Student-Satellite-IITB/Communication-Subsystem/README.md

# Communication-Subsystem
This repository contains all codes related to the Communication Subsystem for IITBSSP CubeSat Mission

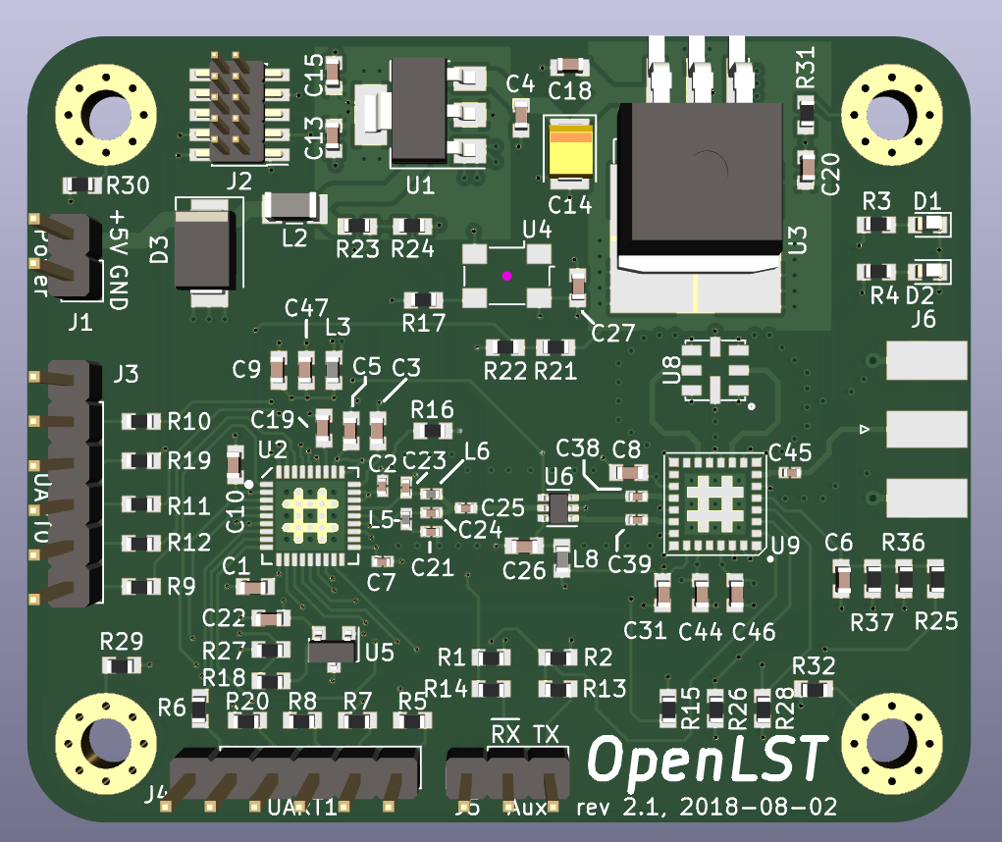
[picture p1: Images/openlst-board.png]
OpenLST Transceiver Board


Current status: 
- Literature Review
- Link Budget Analysis
