Student-Satellite-IITB/Communication-Subsystem/DevelopmentBoards/ADS_v6/Resistor Board/Resistor board.DXF

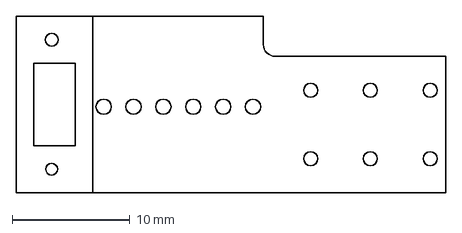
[picture p2: CAD file, 2025-07-12]
DevelopmentBoards/ADS_v6/Resistor Board/Resistor board.DXF
36.5 x 15.0 mm
