Student-Satellite-IITB/Communication-Subsystem/DevelopmentBoards/ADS_v6/Sanket Deployment board/Sanket.step

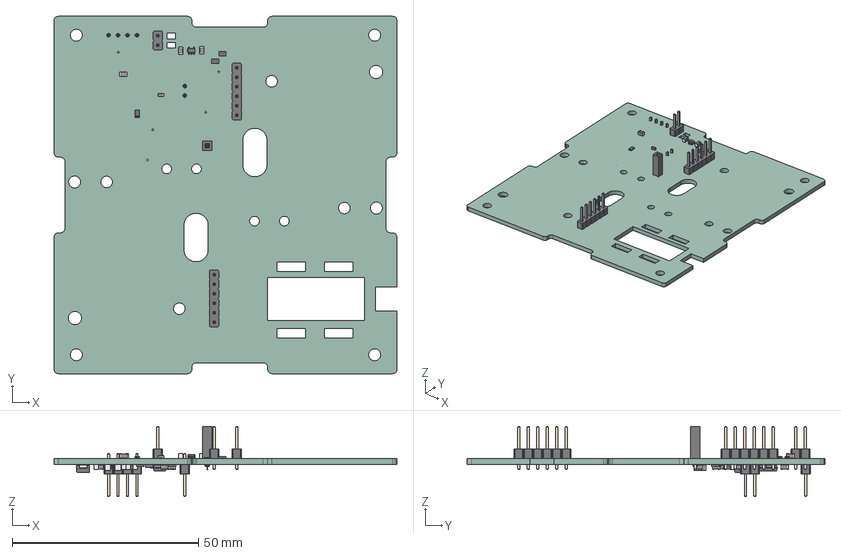
[picture p3: CAD file, 2025-08-22]
DevelopmentBoards/ADS_v6/Sanket Deployment board/Sanket.step
92.0 x 95.9 x 18.8 mm
PinSocket_1x01_P2.54mm_Vertical
PinHeader_1x06_P254mm_Vertical x 2
R_0805_2012Metric x 8
C_0603_1608Metric
C_0805_2012Metric x 17
PinHeader_1x02_P254mm_Vertical x 2
SOT_353_SC_70_5
WSON_6_1EP_2x2mm_P065mm_EP1x16mm
C_1206_3216Metric x 2
D_SMB
PinHeader_1x04_P254mm_Vertical
DGQ0010D_ASM
sanket_PCB
