Student-Satellite-IITB/Communication-Subsystem/DevelopmentBoards/ADS_v6/Sanket Deployment board/Ref_PCB.dxf

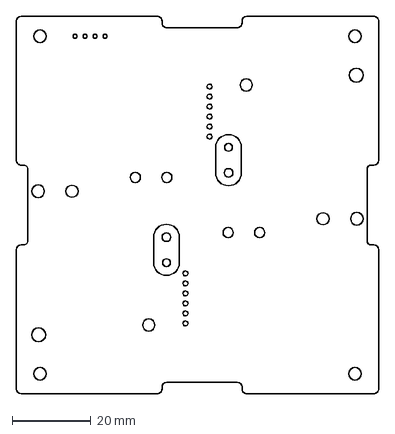
[picture p4: CAD file, 2025-07-12]
DevelopmentBoards/ADS_v6/Sanket Deployment board/Ref_PCB.dxf
92.0 x 95.9 mm
