Student-Satellite-IITB/Communication-Subsystem/DevelopmentBoards/ADS_v4/Sanket Deployment board/Sanket.step

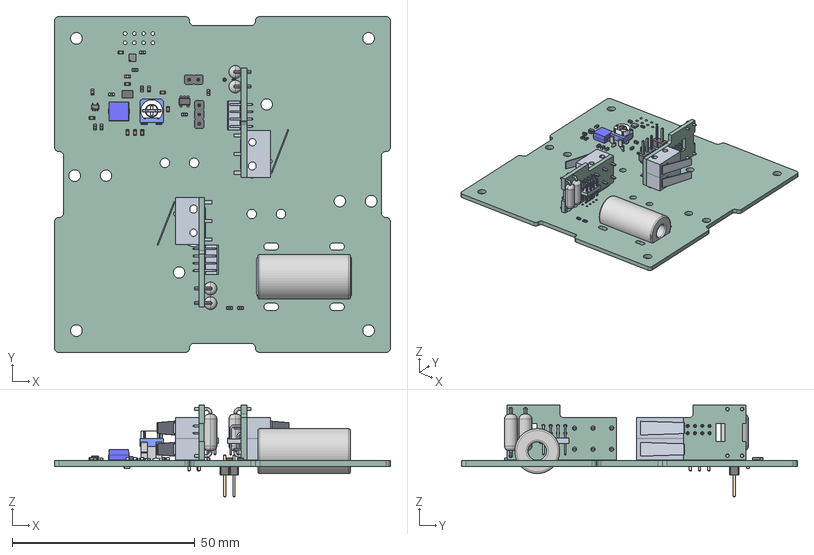
[picture p5: CAD file, 2025-03-31, an earlier design]
DevelopmentBoards/ADS_v4/Sanket Deployment board/Sanket.step
92.0 x 92.0 x 25.1 mm
ASSEMBLY x 12
C0603C823K4RACTU x 11
MAX825TEUK+T
PinHeader_1x02_P254mm_Vertical x 2
DCK5
ferrite v1
PinHeader_1x03_P254mm_Vertical
Trimpot Horiz 5mm v4
resistor_board 1 x 2
RWY0009C_ASM
DRV6
sanket 4.0_PCB
