Student-Satellite-IITB/Communication-Subsystem/Testing/README.md

# Communication-Subsystem Design and Analysis

This document is a work in progress
