Student-Satellite-IITB/Communication-Subsystem/(threads)

Thread 2 (2025-03-31):

ADS board

paritkary25, 2025-03-31:
The ADS project is blank. Upload correct ADS mainboard and detector board files.
