Student-Satellite-IITB/Communication-Subsystem/DevelopmentBoards/ADS_v6/Sanket Deployment board/sch.pdf

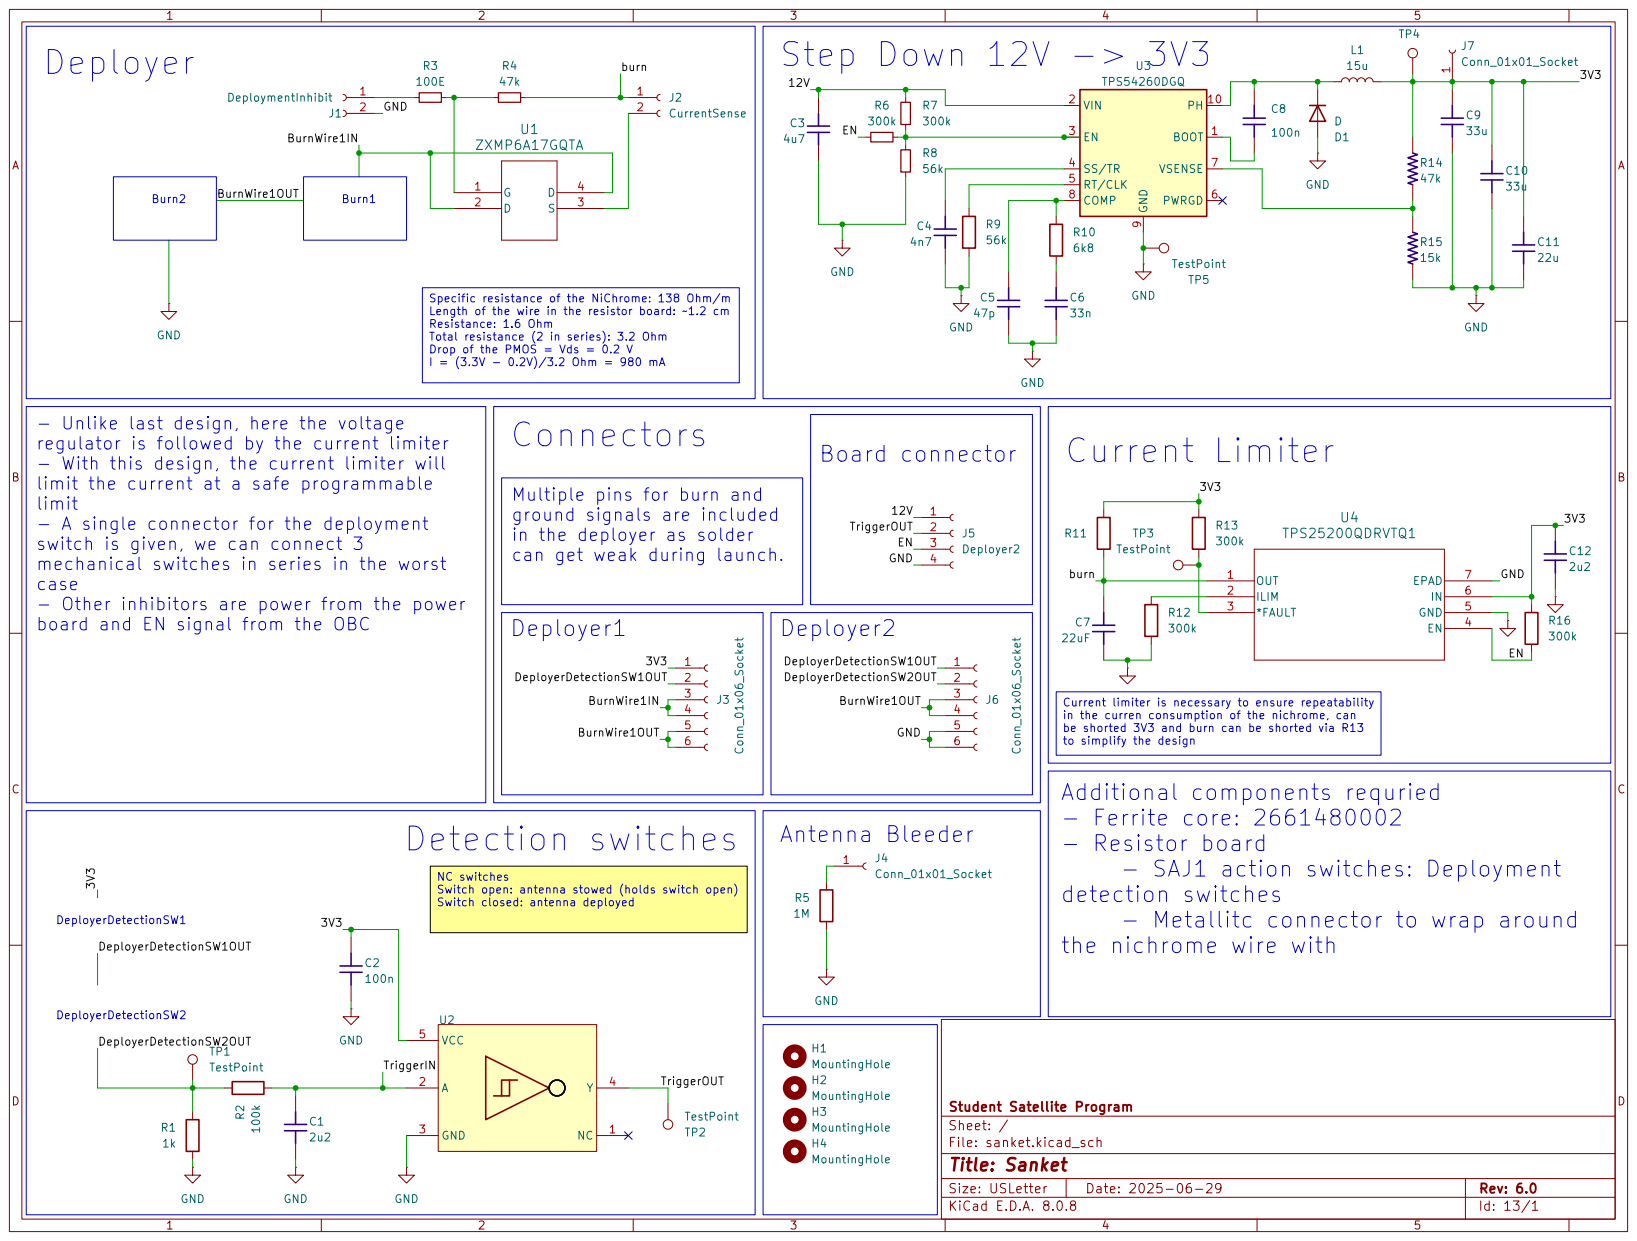
[picture p6: page 1]
