Student-Satellite-IITB/Communication-Subsystem/(list of files, drawings)

Other design files:
DevelopmentBoards/ADS_v6/Resistor Board/electromechanical.PcbLib
DevelopmentBoards/ADS_v6/Resistor Board/electromechanical.SchLib
