Student-Satellite-IITB/Communication-Subsystem/DevelopmentBoards/ADS_v6/Resistor Board/resistor_board.kicad_pcb

## KiCad design DevelopmentBoards/ADS_v6/Resistor Board/resistor_board.kicad_pcb (2025-07-12)

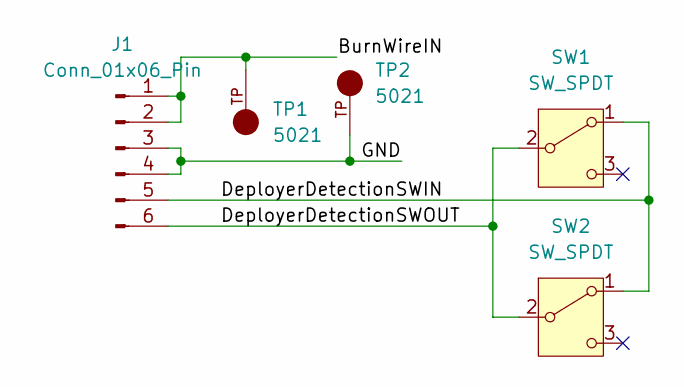
[picture p7: schematic resistor_board.kicad_sch, Antenna Burn Wire PCB]

Parts:
J1: Conn_01x06_Pin; PinHeader_1x06_P2.54mm_Vertical
SW1, SW2: SW_SPDT; D2F-L_OMR
TP1, TP2: 5021; TP_5021; PARTREV B

Connections:
/BurnWireIN: J1.1, J1.2, TP1.TP
/DeployerDetectionSWIN: J1.5, SW1.1 (A), SW2.1 (A)
/DeployerDetectionSWOUT: J1.6, SW1.2 (B), SW2.2 (B)
/GND: J1.3, J1.4, TP2.TP

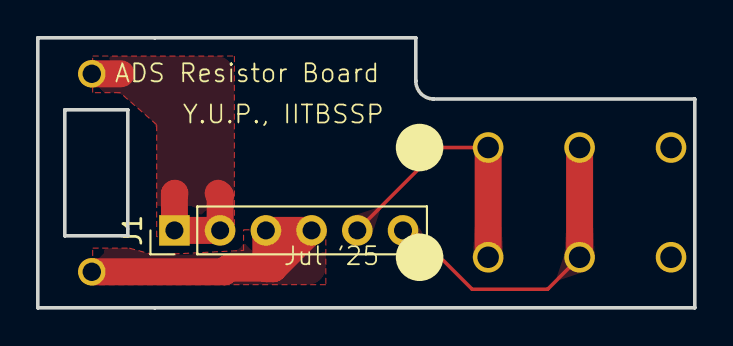
[picture p8: board DevelopmentBoards/ADS_v6/Resistor Board/resistor_board.kicad_pcb from above]

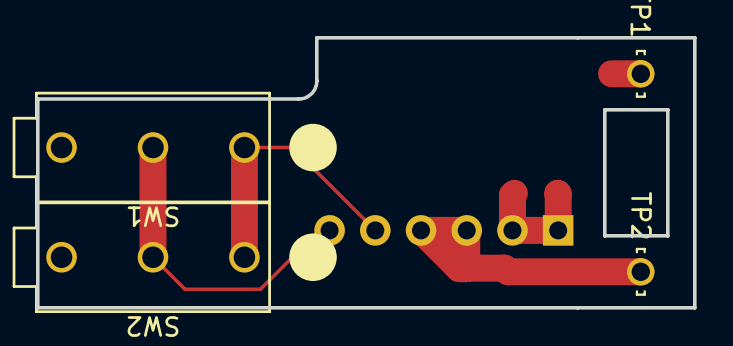
[picture p9: board DevelopmentBoards/ADS_v6/Resistor Board/resistor_board.kicad_pcb from below]

Board: 2 copper layers, 36.5 x 15.0 mm, 5 parts (4 on the bottom side), 4 nets.
