Student-Satellite-IITB/Communication-Subsystem/DevelopmentBoards/ADS_v6/Sanket Deployment board/sanket.kicad_pcb

## KiCad design DevelopmentBoards/ADS_v6/Sanket Deployment board/sanket.kicad_pcb (2025-08-22)

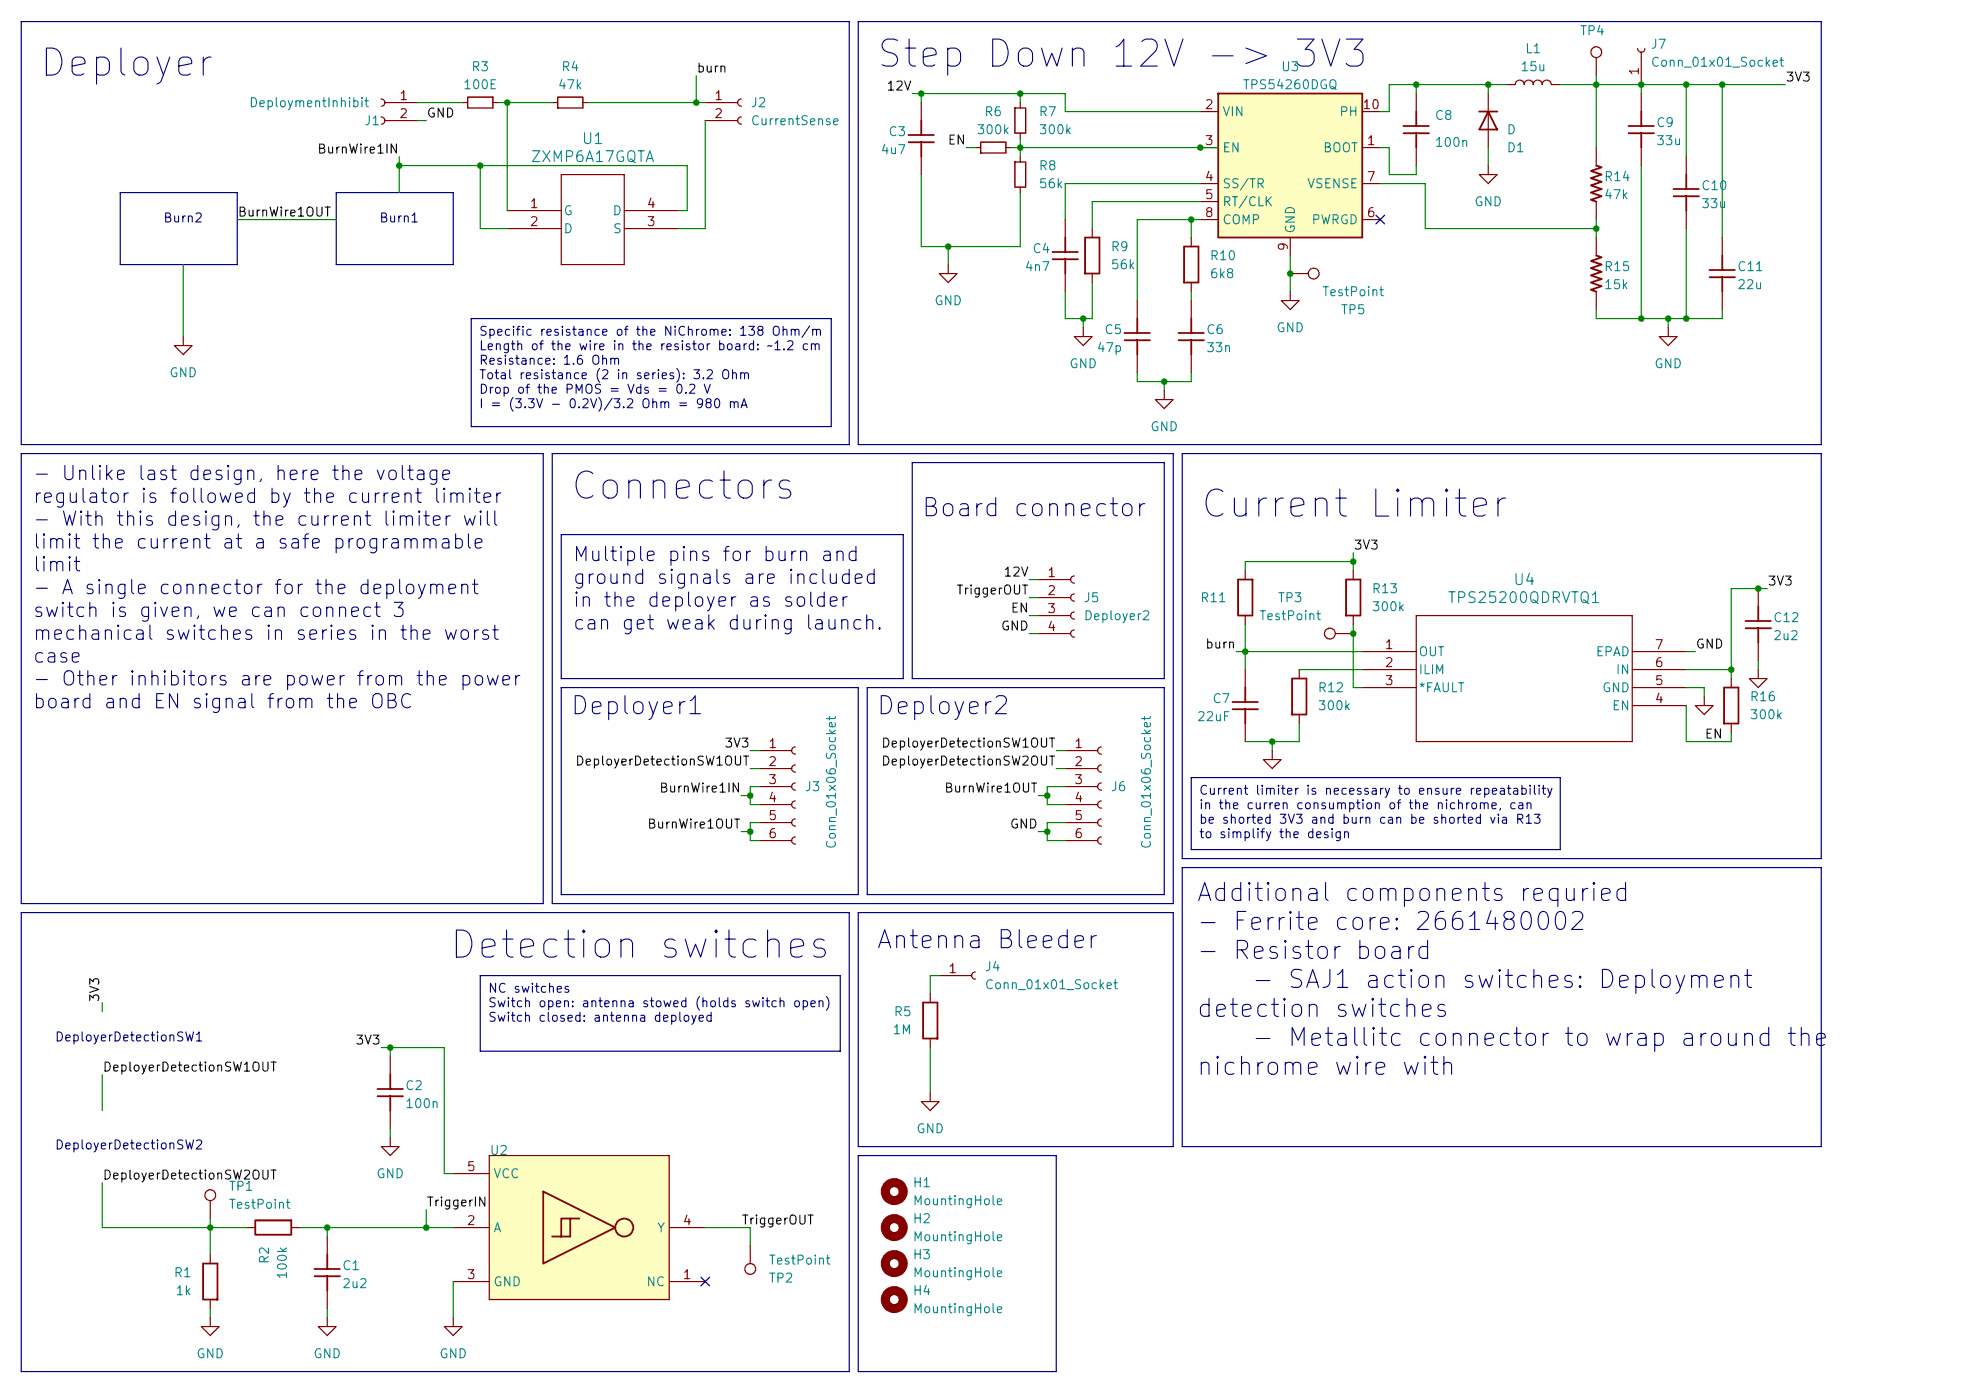
[picture p10: schematic sanket.kicad_sch]

Parts:
C1, C12: 2u2; C_0805_2012Metric
C2: 100n; C_0805_2012Metric
C3: 4u7; C_0805_2012Metric; MANUFACTURER PART NUMBER C0603C475K8PACTU
C4: 4n7; C_0805_2012Metric; MANUFACTURER PART NUMBER C0603C475K8PACTU
C5: 47p; C_0805_2012Metric; MANUFACTURER PART NUMBER C0603C475K8PACTU
C6: 33n; C_0805_2012Metric; MANUFACTURER PART NUMBER C0603C475K8PACTU
C7: 22uF; C_0805_2012Metric
C8: 100n; C_0805_2012Metric; MANUFACTURER PART NUMBER C0603C475K8PACTU
C9, C10: 33u; C_1206_3216Metric; MANUFACTURER PART NUMBER C0603C475K8PACTU
C11: 22u; C_0805_2012Metric; MANUFACTURER PART NUMBER C0603C475K8PACTU
D1: D; D_SMA-SMB_Universal_Handsoldering
H1, H2, H3, H4: MountingHole; MountingHole_3.2mm_M3
J1: DeploymentInhibit; PinHeader_1x02_P2.54mm_Vertical
J2: CurrentSense; PinHeader_1x02_P2.54mm_Vertical
J3, J6: Conn_01x06_Socket; PinHeader_1x06_P2.54mm_Vertical
J4, J7: Conn_01x01_Socket; PinSocket_1x01_P2.54mm_Vertical
J5: Deployer2; PinHeader_1x04_P2.54mm_Vertical
L1: 15u; L_Wurth_WE-XHMI-5050
R1: 1k; R_0805_2012Metric
R2: 100k; R_0805_2012Metric
R3: 100E; C_0805_2012Metric
R4, R14: 47k; C_0805_2012Metric
R5: 1M; R_0805_2012Metric
R6, R7: 300k; C_0805_2012Metric
R8: 56k; C_0805_2012Metric
R9: 56k; R_0805_2012Metric
R10: 6k8; R_0805_2012Metric
R11: 300k; C_0603_1608Metric
R12, R13, R16: 300k; R_0805_2012Metric
R15: 15k; C_0805_2012Metric
TP1, TP2, TP3, TP4, TP5: TestPoint; TestPoint_THTPad_1.0x1.0mm_Drill0.5mm
U1: ZXMP6A17GQTA; SOT-223_DIO
U2: SN74LVC1G17QDCKRQ1; SOT-353_SC-70-5
U3: TPS54260DGQ; HVSSOP-10-1EP_3x3mm_P0.5mm_EP1.57x1.88mm
U4: TPS25200QDRVTQ1; WSON-6-1EP_2x2mm_P0.65mm_EP1x1.6mm

Connections:
/3V3: C2.2, C9.2, C10.2, C11.2, C12.2, J3.1, J7.1, L1.2, R11.2, R13.1, R14.1, R16.1, TP4.1, U2.5 (VCC), U4.6 (IN)
/12V: C3.2, J5.1, R7.1, U3.2 (VIN)
/BurnWire1IN: J3.3, J3.4, U1.2 (D), U1.4 (D)
/BurnWire1OUT: J3.5, J3.6, J6.3, J6.4
/DeployerDetectionSW1OUT: J3.2, J6.1
/DeployerDetectionSW2OUT: J6.2, R1.1, R2.1, TP1.1
/EN: J5.3, R6.1, R16.2, U4.4 (EN)
/TriggerIN: C1.2, R2.2, U2.2 (A)
/TriggerOUT: J5.2, TP2.1, U2.4 (Y)
/burn: C7.2, J2.1, R4.2, R11.1, U4.1 (OUT)
GND: C1.1, C2.1, C3.1, C4.1, C5.1, C6.1, C7.1, C9.1, C10.1, C11.1, C12.1, D1.2 (A), J1.2, J5.4, J6.5, J6.6, R1.2, R5.2, R8.2, R9.2, R12.2, R15.2, TP5.1, U2.3 (GND), U3.9 (GND), U3.11 (GND), U4.5 (GND), U4.7 (EPAD)
unnamed: C6.2, R10.2
unnamed: C8.2, D1.1 (K), L1.1, U3.10 (PH)
unnamed: J1.1, R3.2
unnamed: J2.2, U1.3 (S)
unnamed: J4.1, R5.1
unnamed: R3.1, R4.1, U1.1 (G)
unnamed: C8.1, U3.1 (BOOT)
unnamed: C5.2, R10.1, U3.8 (COMP)
unnamed: R6.2, R7.2, R8.1, U3.3 (EN)
unnamed: R9.1, U3.5 (RT/CLK)
unnamed: C4.2, U3.4 (SS/TR)
unnamed: R14.2, R15.1, U3.7 (VSENSE)
unnamed: R13.2, TP3.1, U4.3 (*FAULT)
unnamed: R12.1, U4.2 (ILIM)

Notes on the sheet:
Multiple pins for burn and ground signals are included in the deployer as solder can get weak during launch.
NC switches Switch open: antenna stowed (holds switch open) Switch closed: antenna deployed
- Unlike last design, here the voltage regulator is followed by the current limiter - With this design, the current limiter will limit the current at a safe programmable limit - A single connector for the deployment switch is given, we can connect 3 mechanical switches in series in the worst case -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
Additional components requried - Ferrite core: 2661480002 - Resistor board - SAJ1 action switches: Deployment detection switches - Metallitc connector to wrap around the nichrome wire with
Current limiter is necessary to ensure repeatability in the curren consumption of the nichrome, can be shorted 3V3 and burn can be shorted via R13 to simplify the design
Specific resistance of the NiChrome: 138 Ohm/m Length of the wire in the resistor board: ~1.2 cm Resistance: 1.6 Ohm Total resistance (2 in series): 3.2 Ohm Drop of the PMOS = Vds = 0.2 V I = (3.3V - 0.2V)/3.2 Ohm = 980 mA
Step Down 12V -> 3V3
Detection switches
Connectors
Board connector
Deployer
Burn1
DeployerDetectionSW1
Deployer2
Current Limiter
Deployer1
DeployerDetectionSW2
Burn2
Antenna Bleeder

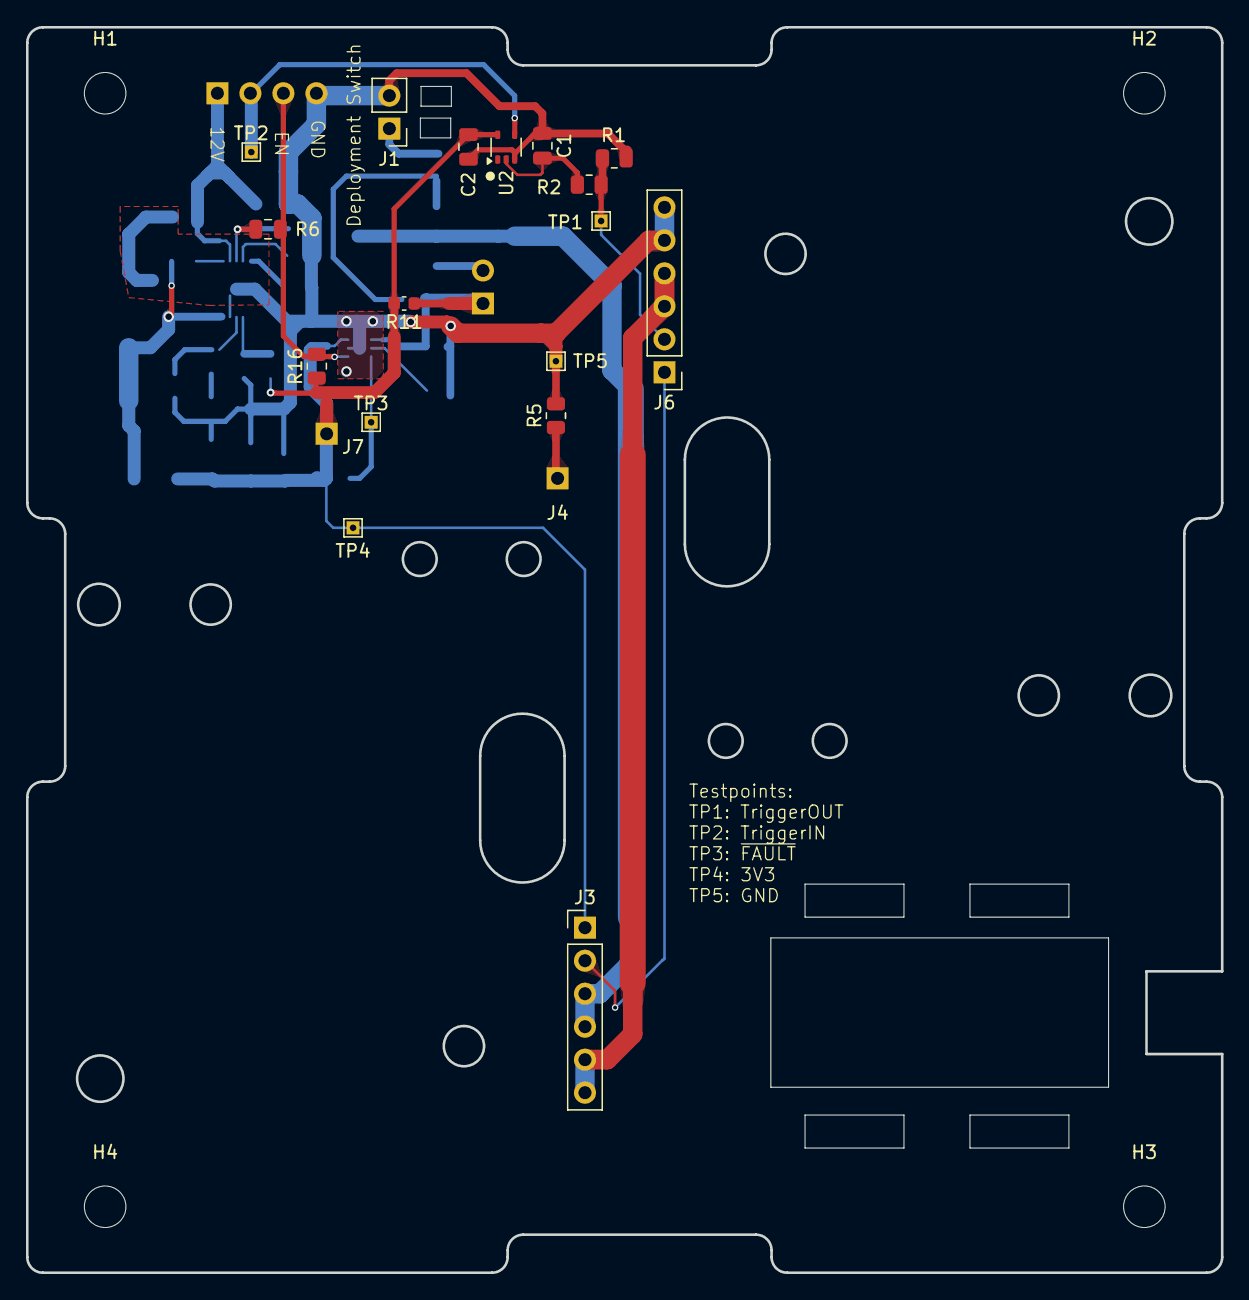
[picture p11: board sanket.kicad_pcb from above]

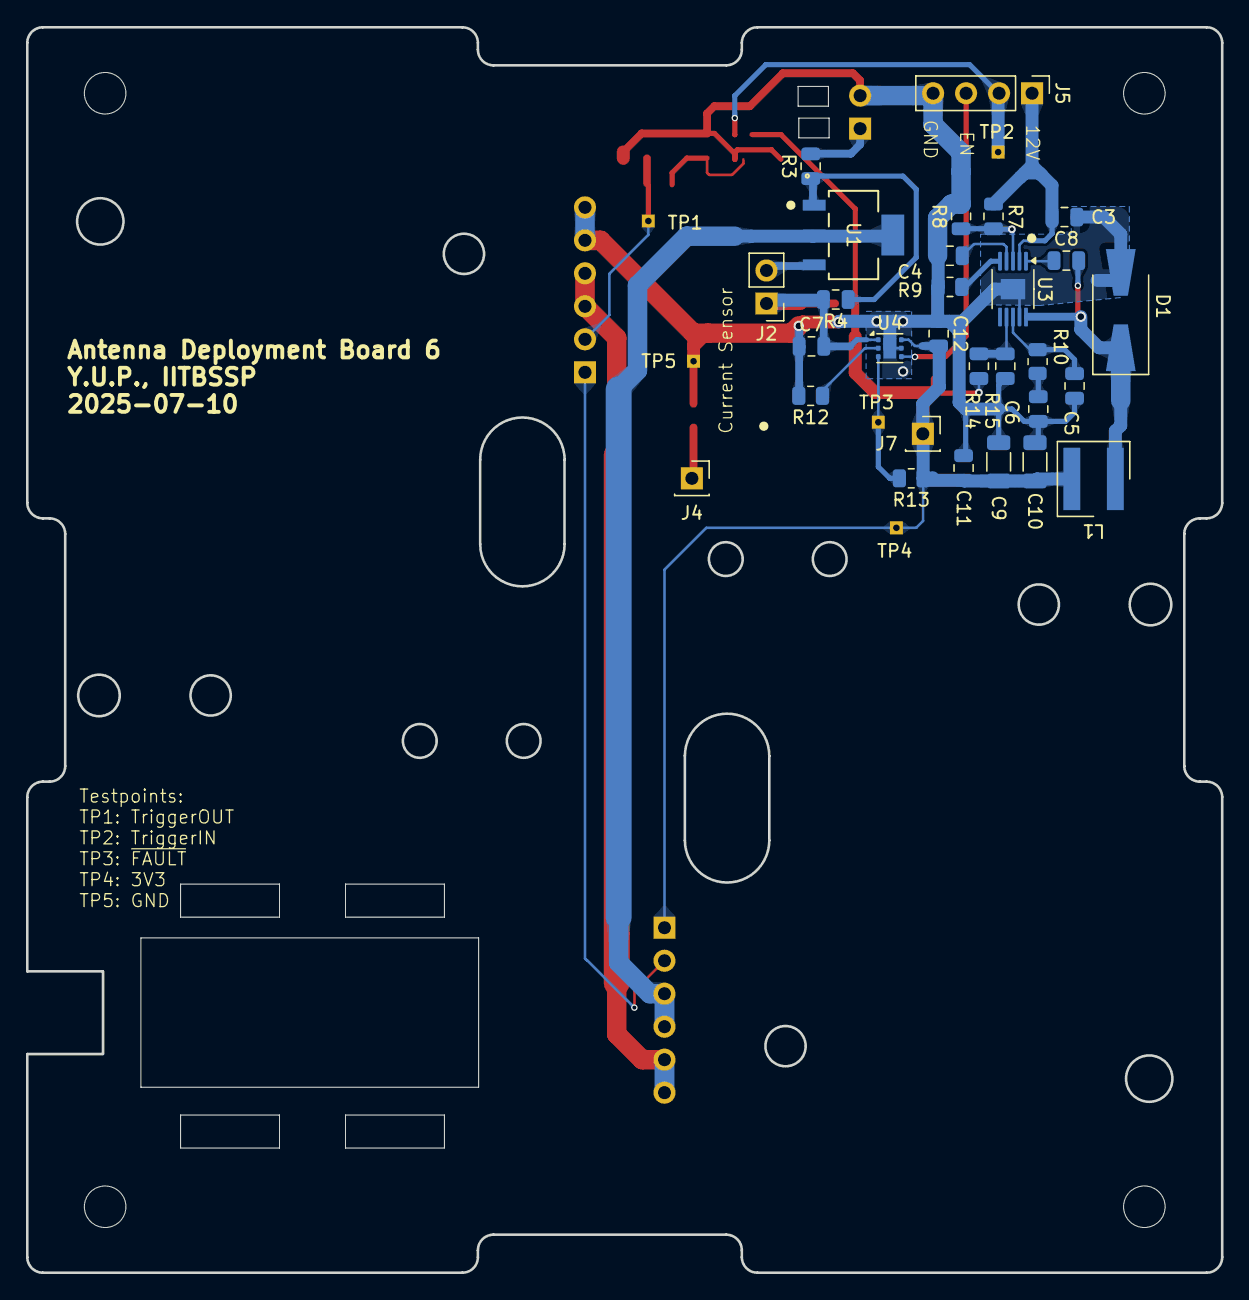
[picture p12: board sanket.kicad_pcb from below]

Board: 2 copper layers, 92.0 x 95.9 mm, 50 parts (29 on the bottom side), 25 nets.
