Student-Satellite-IITB/Communication-Subsystem/DevelopmentBoards/ADS_v4/Sanket Deployment board/sanket 4.0.kicad_pcb

## KiCad design DevelopmentBoards/ADS_v4/Sanket Deployment board/sanket 4.0.kicad_pcb (2025-03-31, an earlier design)

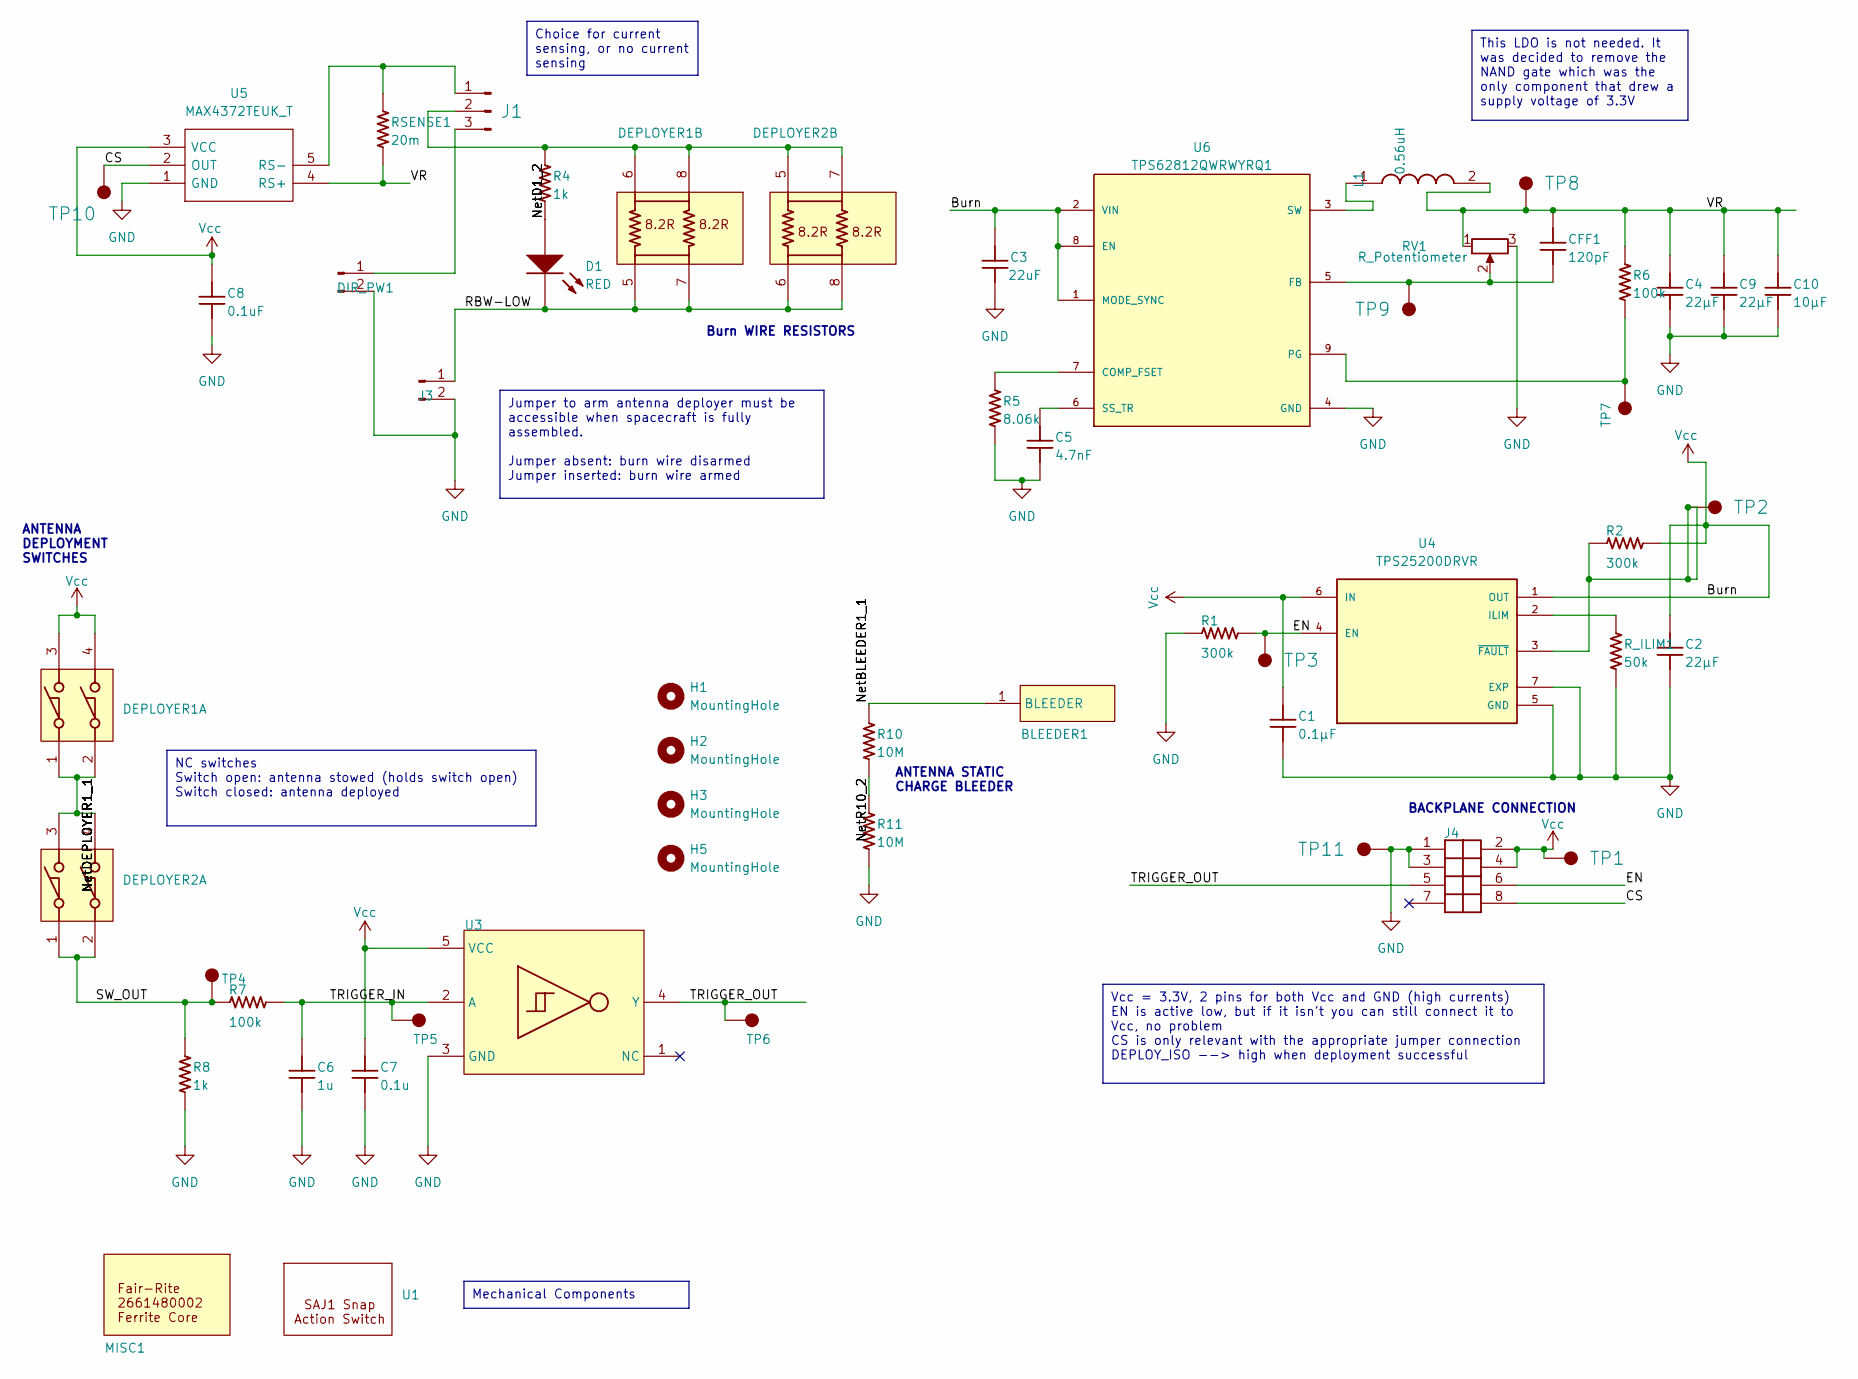
[picture p13: schematic sanket 4.0.kicad_sch, Sanket]

Parts:
BLEEDER1: Present (no need to buy); MISC-BLEEDER-PAD
C1: 0.1µF; CAP-0603-KEMET
C2: 22µF; CAP-0603-KEMET
C3: 22uF; CAP-0603-KEMET; MANUFACTURER PART NUMBER C0603C475K8PACTU
C4, C9: 22µF; CAP-0603-KEMET; MANUFACTURER PART NUMBER C0603C475K8PACTU
C5: 4.7nF; CAP-0603-KEMET; MANUFACTURER PART NUMBER C0603C475K8PACTU
C6: 1u; CAP-0603-KEMET
C7: 0.1u; CAP-0603-KEMET
C8: 0.1uF; CAP-0603-KEMET
C10: 10µF; CAP-0603-KEMET; MANUFACTURER PART NUMBER C0603C475K8PACTU
CFF1: 120pF; CAP-0603-KEMET; MANUFACTURER PART NUMBER C0603C475K8PACTU
D1: RED; LED_0603_150060RS75000
DEPLOYER1: MECH-Deployer-Shield
DEPLOYER2: MECH-DEPLOYER-CENTRE
DIR_PW1: ARM_Header; PinHeader_1x02_P2.54mm_Vertical
H1, H2, H3, H5: MountingHole; MountingHole_3.2mm_M3
J1: HEAD-RA-SMT-2.54mm-1x3; PinHeader_1x03_P2.54mm_Vertical; Manufacturer Part Number M20-8890345
J3: ARM_Header; PinHeader_1x02_P2.54mm_Vertical
J4: Backplane; HEAD_TSW-104-14-L-D
L1: 0.56uH; L_Bourns_SRP5030T; Manufacturer_Part_Number SRP5030CA-R56M
MISC1: Ferrite bead; MISC-FERRITE-2661480002
R1, R2: 300k; RES_0603_Panasonic
R4, R8: 1k; RES_0603_Panasonic
R5: 8.06k; RES_0603_Panasonic
R6: 100k; RES_0603_Panasonic
R7: 100k; RES_0603_Panasonic; MANUFACTURER PART NUMBER ERJ3EKF1003V
R10, R11: 10M; RES_0603_Panasonic
RSENSE1: 20m; RES_0603_Panasonic
RV1: R_Potentiometer; Potentiometer_Runtron_RM-065_Vertical
R_ILIM1: 50k; RES_0603_Panasonic
TP1, TP2, TP3, TP4, TP5, TP6, TP7, TP8, TP9, TP10, TP11: Test points; MISC-TP-SURF
U1: (no value)
U3: SN74LVC1G17QDCKRQ1; IC_SC70-5
U4: TPS25200DRVR; SON65P200X200X80-7N; PARTREV D; DigiKey_Part_Number 296-37842-2-ND
U5: MAX4372TEUK_T; SOT95P280X145-5N; MPN MAX4372TEUK+T; DigiKey_Part_Number MAX4372TEUK+TTR-ND
U6: TPS62812QWRWYRQ1; RWY0009A; MANUFACTURER_PART_NUMBER TPS62812QWRWYRQ1

Connections:
/CS: J4.8, TP10.1, U5.2 (OUT)
/EN: J4.6, R1.2, TP3.1, U4.4 (EN)
/NetBLEEDER1_1: BLEEDER1.1 (BLEEDER), R10.1
/NetD1_2: D1.2 (A), R4.1
/NetDEPLOYER1_1: DEPLOYER1.1, DEPLOYER1.2, DEPLOYER2.3, DEPLOYER2.4
/NetR10_2: R10.2, R11.1
/RBW-LOW: D1.1 (K), DEPLOYER1.5, DEPLOYER1.7, DEPLOYER2.6, DEPLOYER2.8, J3.1
/SW_OUT: DEPLOYER2.1, DEPLOYER2.2, R7.1, R8.2, TP4.1
/TRIGGER_IN: C6.2, R7.2, TP5.1, U3.2 (A)
/TRIGGER_OUT: J4.5, TP6.1, U3.4 (Y)
/VR: C4.2, C9.2, C10.2, CFF1.2, L1.2, R6.1, RSENSE1.1, RV1.1, TP8.1, U5.4 (RS+)
GND: C1.1, C2.1, C3.1, C4.1, C5.1, C6.1, C7.1, C8.1, C9.1, C10.1, DIR_PW1.2, J3.2, J4.1, J4.3, R1.1, R5.2, R8.1, R11.2, RV1.3, R_ILIM1.2, TP11.1, U3.3 (GND), U4.5 (GND), U4.7 (EXP), U5.1 (GND), U6.4 (GND)
unnamed: DIR_PW1.1, J1.3
unnamed: J1.1, RSENSE1.2, U5.5 (RS-)
unnamed: DEPLOYER1.6, DEPLOYER1.8, DEPLOYER2.5, DEPLOYER2.7, J1.2, R4.2
unnamed: R_ILIM1.1, U4.2 (ILIM)
unnamed: R2.1, TP2.1, U4.3 (~FAULT)
unnamed: R5.1, U6.7 (COMP_FSET)
unnamed: CFF1.1, RV1.2, TP9.1, U6.5 (FB)
unnamed: R6.2, TP7.1, U6.9 (PG)
unnamed: C5.2, U6.6 (SS_TR)
unnamed: L1.1, U6.3 (SW)

Notes on the sheet:
ANTENNA STATIC CHARGE BLEEDER
This LDO is not needed. It was decided to remove the NAND gate which was the only component that drew a supply voltage of 3.3V
Burn WIRE RESISTORS
Mechanical Components
ANTENNA DEPLOYMENT SWITCHES
NC switches Switch open: antenna stowed (holds switch open) Switch closed: antenna deployed
Vcc = 3.3V, 2 pins for both Vcc and GND (high currents) EN is active low, but if it isn't you can still connect it to Vcc, no problem CS is only relevant with the appropriate jumper connection DEPLOY_ISO --> high when deployment successful
BACKPLANE CONNECTION
Choice for current sensing, or no current sensing
Jumper to arm antenna deployer must be accessible when spacecraft is fully assembled. Jumper absent: burn wire disarmed Jumper inserted: burn wire armed

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
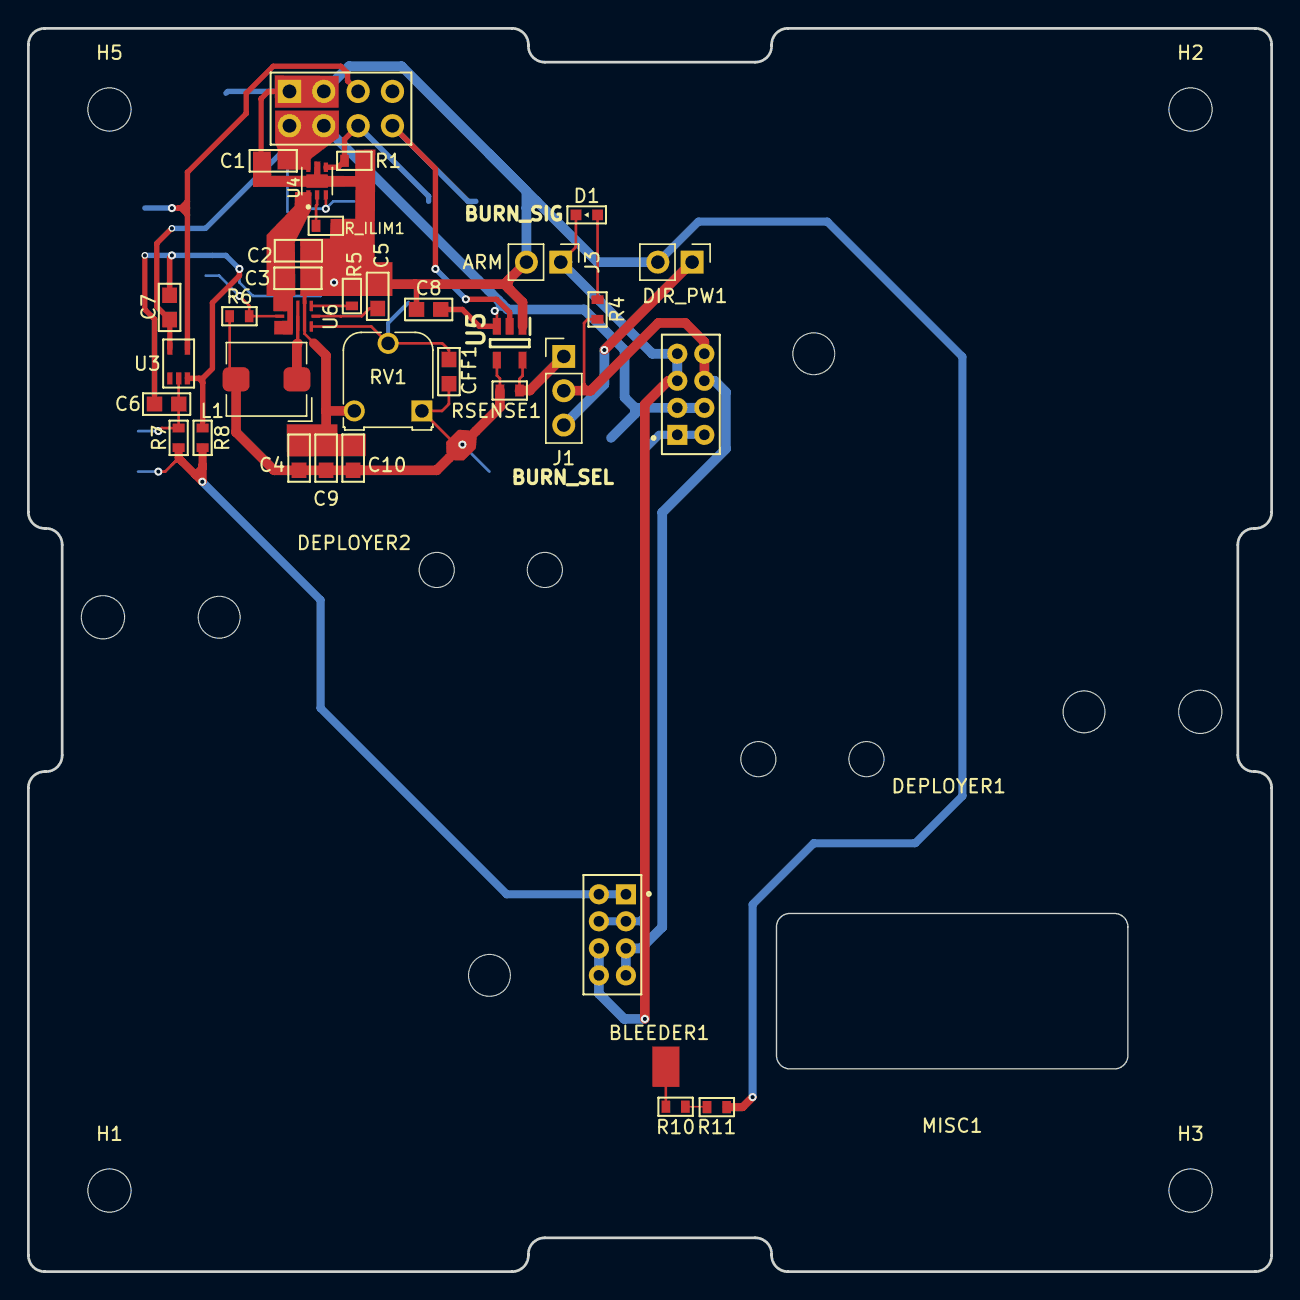
[picture p14: board sanket 4.0.kicad_pcb from above]

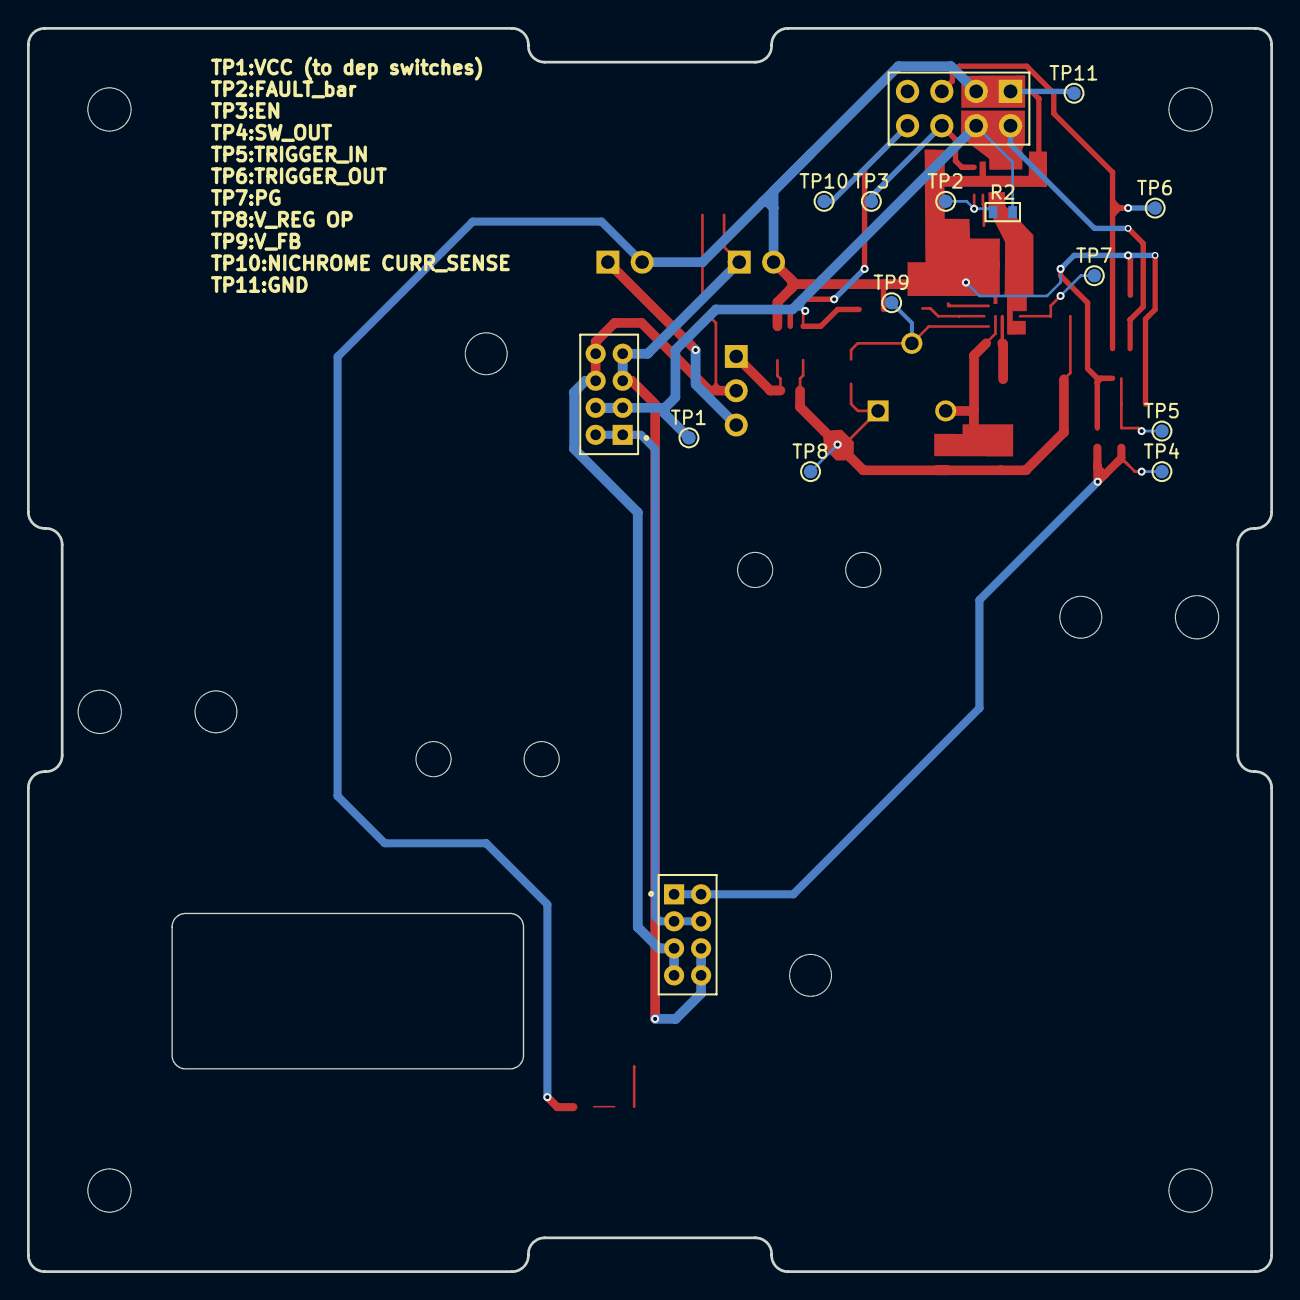
[picture p15: board sanket 4.0.kicad_pcb from below]

Board: 2 copper layers, 92.0 x 92.0 mm, 52 parts (12 on the bottom side), 24 nets.
