Student-Satellite-IITB/Communication-Subsystem/DevelopmentBoards/ADS_v4/Resistor Board/resistor_board.kicad_pcb

## KiCad design DevelopmentBoards/ADS_v4/Resistor Board/resistor_board.kicad_pcb (2025-03-31, an earlier design)

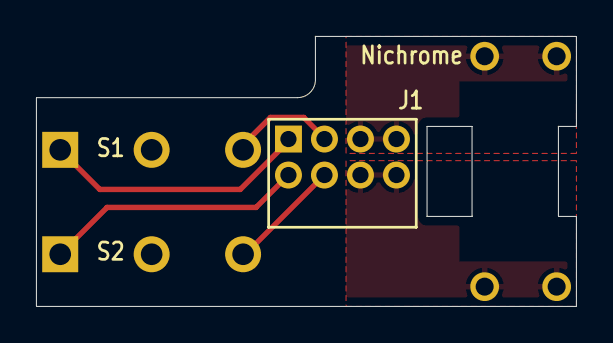
[picture p16: board DevelopmentBoards/ADS_v4/Resistor Board/resistor_board.kicad_pcb from above]

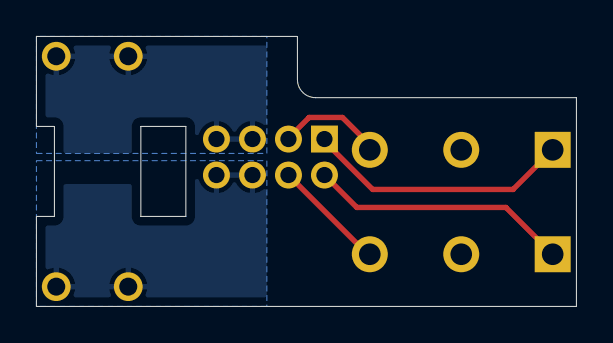
[picture p17: board DevelopmentBoards/ADS_v4/Resistor Board/resistor_board.kicad_pcb from below]

Board: 4 copper layers, 30.0 x 15.0 mm, 5 parts (2 on the bottom side), 6 nets.

Parts:
J1: TMM-104-01-X-D-RA
Nichrome: UB3C
R2: UB3C
S1, S2: D2F-L

Connections:
R_HI: J1.6, J1.8, Nichrome.2, R2.2
R_LO: J1.5, J1.7, Nichrome.1, R2.1
S1_COM: J1.1, S1.1
S1_NC: J1.3, S1.2
S2_COM: J1.2, S2.1
S2_NC: J1.4, S2.2
