Student-Satellite-IITB/Communication-Subsystem/(commit log)

2025-01-12 Comm Board v2.0 Design
    started designing v2.0 of Comm board
    [RF.kicad_sch, TransceiverBoard.kicad_pcb, TransceiverBoard.kicad_sch]
2025-03-31 add Sanket and Resistor board
    [Sanket.step, electromechanical.PcbLib, electromechanical.SchLib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]
2025-07-12 Add new version Move old board files to v4
    [RF.kicad_sch, Ref_PCB.dxf, Resistor board.DXF, Sanket.step, TransceiverBoard.kicad_pcb, TransceiverBoard.kicad_sch, electromechanical.PcbLib, electromechanical.SchLib]
2025-07-25 add bom
    [sanket.kicad_sch]
2025-07-27 add bom, update .gitignore
2025-08-24 update sch pdf
    [FinalBOM.csv]
